its-kronos/Databoard/Production/PCB/Databoard_BOM_FINAL.csv

No. | Quantity | Comment | Designator | Footprint | Value | Manufacturer Part | Manufacturer | Supplier Part | Supplier
1 | 6 | 100nF | C1,C2,C3,C4,C9,C13 | C0402 | 100nF | CL05B104KB54PNC | SAMSUNG(三星) | C307331 | LCSC
2 | 1 | 4.7uF | C5 | C0402 | 4.7uF | CL05A475MP5NRNC | SAMSUNG(三星) | C23733 | LCSC
3 | 1 | 10nF | C6 | C0402 | 10nF | CL05B103KB5NNNC | SAMSUNG(三星) | C15195 | LCSC
4 | 1 | 1uF | C8 | C0402 | 1uF | CL05A105KA5NQNC | SAMSUNG(三星) | C52923 | LCSC
5 | 2 | 12pF | C11,C12 | C0402 | 12pF | 0402CG120J500NT | FH(风华) | C1547 | LCSC
6 | 1 | 22uF | C16 | C0603 | 22uF | CL10A226MQ8NRNC | SAMSUNG(三星) | C59461 | LCSC
7 | 1 | 10uF | C17 | C0402 | 10uF | CL05A106MQ5NUNC | SAMSUNG(三星) | C15525 | LCSC
8 | 2 | 10pF | C18,C19 | C0402 | 10pF | CL05C100JB5NNNC | SAMSUNG(三星) | C32949 | LCSC
9 | 1 | TF PUSH | CARD1 | TF-SMD_TF-PUSH |  | TF PUSH | SHOU HAN(首韩) | C393941 | LCSC
10 | 1 | SM4007PL | D1 | SOD-123F_L2.8-W1.8-LS3.7-RD |  | SM4007PL | MDD(辰达半导体) | C64898 | LCSC
11 | 3 | SMF5.0A | D2,D3,D4 | SOD-123FL_L2.7-W1.8-LS3.8-RD |  | SMF5.0A | 宏迦橙 | C19077497 | LCSC
12 | 1 | KH-2.54PH180-1X3P-L11.5 | H1 | HDR-TH_3P-P2.54-V-M |  | KH-2.54PH180-1X3P-L11.5 | kinghelm(金航标) | C2932698 | LCSC
13 | 2 | 2.54-1*20P直针 | J1,J2 | HDR-TH_20P-P2.54-V-M-1 |  | 2.54-1*20P直针 | BOOMELE(博穆精密) | C50981 | LCSC
14 | 4 | BSS84 | Q1,Q2,Q3,Q4 | SOT-23-3_L2.9-W1.3-P1.90-LS2.4-BR-1 |  | BSS84 | 宏嘉诚 | C7420340 | LCSC
15 | 6 | 10kΩ | R1,R5,R7,R8,R9,R10 | R0402 | 10kΩ | 0402WGF1002TCE | UNI-ROYAL(厚声) | C25744 | LCSC
16 | 2 | 5.1kΩ | R2,R3 | R0402 | 5.1kΩ | 0402WGF5101TCE | UNI-ROYAL(厚声) | C25905 | LCSC
17 | 1 | 1.5kΩ | R6 | R0402 | 1.5kΩ | 0402WGF1501TCE | UNI-ROYAL(厚声) | C25867 | LCSC
18 | 2 | TS-1088-AR02016 | SW1,SW2 | SW-SMD_L3.9-W3.0-P4.45 |  | TS-1088-AR02016 | XUNPU(讯普) | C720477 | LCSC
19 | 1 | STM32F103C8T6 | U1 | LQFP-48_L7.0-W7.0-P0.50-LS9.0-BL |  | STM32F103C8T6 | ST(意法半导体) | C8734 | LCSC
20 | 1 | AMS1117-3.3 | U2 | SOT-223-3_L6.5-W3.4-P2.30-LS7.0-BR |  | AMS1117-3.3 | AMS | C6186 | LCSC
21 | 1 | 2.4GHz | U3 | WIFI-SMD_ESP32-MINI-1-N4 | 2.4GHz | ESP32-S2-MINI-2-N4 | ESPRESSIF(乐鑫) | C3013906 | LCSC
22 | 1 | TYPE-C16PIN | USB1 | USB-C-SMD_TYPE-C16PIN |  | TYPE-C16PIN | SHOU HAN(首韩) | C393939 | LCSC
23 | 1 | 16MHz | X1 | OSC-SMD_4P-L3.2-W2.5-BL | 16MHz | X322516MLB4SI | YXC(扬兴晶振) | C13738 | LCSC
24 | 1 | 32.768kHz | X2 | OSC-SMD_L3.2-W1.5 | 32.768kHz | SC-32S32.768kHz20PPM7pF | Seiko(精工) | C97604 | LCSC
