its-kronos/Databoard/(list of files, drawings)

Other design files:
PCB/Databoard.epro
