its-kronos/Databoard/JOURNAL.md

Total design time: 22.75h

# 8/1/25

- Started by creating some ideas of what I generally wanted this project to be, and thanks to a few people, I came up with a basic idea.



- After coming up with the basic idea, I started to look at documentation for the STM32 chip I was going to be using, and started creating the schematic, which was pretty easy, but just a bit challenging since I've only been used to the Raspberry Pi documentation for their chips, which were very detailed and easy to follo whwne compared to STM







- Towards the end, I knew that a crystal that works with this chip would be hard to find. I looked at the only basic JLCPCB part (which would avoid a 3 dollar fee for assembly) that resonates at 16 MHZ, and it took about an hour of calculating to determine that it was probably fine. The only thing I wasn't able to calculate was how good the crystal would be over periods of time since I would need to measure how current flows through the crystal, which would be impossible without specific tools (oscilloscope) and the crystal itself.

- 

- Also, I decided that I would be "starting over" and creating the PCB in easyEDA instead of Kicad since the Twist You Ship We Ship of Hackclub has two possible routes of funding for the PCB. One of them is to use any EDA but track your time, which doesn't include looking at documentation for 5 dollars an hour, or using easyEDA and receiving a grant from JLCPCB instead, with any amount of time
- Using easyEDA would mean that I wouldn't have to worry about the PCB budget, especially since most of it isn't even tracked due to how documentation heavy hardware design can be

**time: 3 hours**

# 8/3/25

- Ported over everything to easyEDA (without importing, just remade everything)
- After, I added a 32.768 KHZ crystal for the RTC of the chip to be more accurate, especially since time tracking is something that can be fundamental for a board based on collecting data.
- Finally, I started implementing USBC and esd protection with the USBLC6, but then I learned about how I could use TVS diodes for protection, which would be cheaper, and something I implement during the next session.



- Also, towards the end, I learned about how the specific MCU I'm using requires 1.5k Ohm pull up resistor on USB DP, and after doing some research I decided that the next session I would include an P channel mosfet to control it



**time: 2.5 hours**

- Finished circuits for USB + ESD protection



- Did a lot of research on what type of converter I should use, since I would like for it to be compatable with different types of batteries, but this wasn't the easiest due to trying to make the board as cheap as possible. I was able to find a convertor that would allow for a stable conversion from 4.5 volts to 16 volts, which would be pretty good for things like 9V battery



**time: 1 hour**

# 8/4/25

- Started laying out everything and sourced other parts, such as the WIFI module and microSD reader, and then learned about how LDOs (the dropout voltage regulator I chose) would be inefficient, so now I'm trying to find a buck regulator instead





**time: 2 hours**

- Did some research about a buck regulator, but turns out they would require way too many extended components, so although it would be less efficient, it would drive up the costs



- Changed up the layout a bit to make it neater as well as finished it, and added headers for debugging (SWDIO), and then started some of the start of routing, especially for important traces like USB and some of the power traces



**time: 2 hours**

# 8/5/25

- Did a lot of the routing for the traces, and GPIO pins, especially the ones at the top of the STM32.



- However, after doing this I noticed that most of the ADC pins (convert Analog signals to binary) would be used for communication with the SD card and the wifi chip, which would be a waste, so I started to restart and better plan this layout, trying to make sure that I would keep in mind which signals are more important than others (like communication between components > GPIO)



**time: 2h 30m**

- I then spent quite a bit of time on routing, trying to make sure that it was neat, and when I got to the part where I had to route a second UART to communicate with the ESP32, I realized that Instead of using two GPIOs, I could use one and have a switch that switches between the REPL UART pins to the UART pins one would use for communicating with custom code. 



- During this time, I was able to successfully route 50% of the GPIO headers (and there were a few moment where I pretty much boxed myself in really badly)

  

  

- This is quite tightly spaced:



**time: 2h45m**

# 8/6/25

- This was a really big session especially due to today being the final day for the YSWS.

- To start, I completely finished routing the board, which was really easy due to it pretty much being only straight lines.
- After, I proceeded to check over everything in the schematic and the documentation, to make sure that everything would work

- Unfortunately, the crystal that I was using for the RTC wouldn't work due to having too much of a load capacitance. This means that I must go with an extended component (which adds 3 dollars to the cost) and also reroute a small amount of the board.



- I also had to end up swapping RX and PB6 here, and the reason for that was that I thought RX (receive) would be sending the signals (I wasn't really thinking about it)



- Now, the only thing left is the art, and I was able to completely finish the top side, which in my opinion, looks really good, but took me a lot of time due to me being pretty bad at art.

image (8)

**time: ~5h**

- I started to add images to the back of the board, and one thing that was a challenge was how imported images always were bottom-most compared to patterns made natively in easyeda which was a pain to fix and move the shapes/reshape them.



- Eventually I was able to get it looking pretty good after quite a bit of time



- Also turns out that multicolor silkscreen requires a white board, and at 0.8mm board thickness it requires a special surcharge of 32 dollars, so I changed it to 1.6 and redid the USB traces, as board thickness impacts impedence.



**time: ~2h**

# 8/18/25

- Got the PCB!!
- Took a couple images in RAW format, which I spent quite a bit of time on
-  Each image was about 100mb, so I'll just share compressed ~10MB versions

 

 

 

 



**time: 30m**

# 8/19/25

- started by trying to make custom circuit python build and set up WSL and did a lot of the steps there. Eventually, I found out that circuit python doesn't support the STM32F1 series due to there being too little inbuilt flash (probably, 64 kb)



- Also, STM32F1 doesn't have an inbuilt USB bootloader, so I have to use an open sourced one and flash via SWD (and I don't have a debugger!)

- To make matters worse, I'm going to have to modify the bootloader for USB enumeration because most of them expect an 8 mhz clock while mine uses a 16 mhz

**time: 1h45m**

# 8/19/25

- I'm tired, and nothing i've tried worked, so there won't be that much for me to add images about, which sucks

- So first, I tried using maple bootloader and after a while I successfully changed the value of a register!
- Turns out this was a waste of time and outdated firmware

- While doing this, i tried to create an SWD interface on a pi 3B+ with openocd (took so long to build), which failed to connect, and then I tried to create one on one of my RP2040 based devboards, which also failed to connect, being another timewaste

- I then moved on to stm32duino and spent a large chunk of time trying to figure out how to change the values of the RCC_CFGR registor to allow for the 16 MHZ clock, but now I just think that its a board plugin for the arduino IDE and not meant to be used as a bootloader (?)

- Anyways, I then tried to do a USB UART bridge on the other devboard, which failed for unknown reasons (works to flash the secondary MCU on the board).
- I spent a while trying to debug this, by using stuff like a nano v3 and an LED to "read" it, but no data came out

- Anyways, I'm just going to sleep on this project and home I can figure out something tomorrow

**time:4h30m**

# 8/20/25

- Turns out, I was using the wrong IO pins. I defined the UART IO pins as 8 and 9, but instead I was using pins 18 and 19, which was 100% my problem.
- After trying to use this, it still failed, but this was because the baudrate was too high, and I was successfully able to properly send and read the byte from the nano.



- Now I should be able to hook it up and flash a binary
- Also, I discovered that for using stm32duino, theres a bootloader derived from Maple that's more up to date, which makes it a lot easier to use

**time 1h45m**

# 8/20/25

- So even though i was able to send the correct byte, the stm32 just refused to respond with anything at all, there isn't much to show for this, since its really just a whole lot of nothing. I spent about 3-ish hours trying to get this to work, but this was futile

- Eventually, I decided to try SWD debug probe via openocd again, and for some reason, it just worked today, and I have no idea why
- Either way, I was able to successfully able to flash a binary onto the device, so the next step would be to customize the opensource maple derivative to account for the 16mhz crystal, which should allow me to use it with stm32duino and in turn, the arduino ide

image (10)

**time 4h (long, I know)**

# 8/21/25

- Recompiled code to work with 16M crystal, which was easy due to their being a config
- Turns out this bootloader only works with DFU, and doesn't work well with arduino, so I did a couple hours of searching online, and eventually found out that theres a new, better bootloader that works with the offical STM32 core for Arduino

- Also, this new bootloader that I will implement next session doesn't require drivers!



**time: 3h15m (mainly due to the failing of the first bootloader)**

# 8/21/25

- The HID bootloader failed, even after doing quite a bit of research

- Eventually found a CDC driver, but it doesn't work with arduino, and the creator of it hasn't updated it anytime recently, so no hope there

- Went back to maple DFU bootloader, and I couldn't get that to work, so I honestly feel that theres nowhere to really go without external help

- Will probably take a break to install Arch linux dual boot while waiting for my account to get approved for stmduino forums

**time: 2h**

# 8/29/25

- Putting the binary directly on to the board wouldn't work obviously due to the crystal mismatch, but after some research i found out that I could create a pull request to add a new board to the offical stm32duino core
- Took a lot longer than expected due to the instructions not being as detailed as I would like, but I was able to get it done



**time: 2.5h**

# 9/12/25

- Fixed up the PR to match the feedback, not much here except me just changing stuff to match what the maintainer for STM32DUINO said to do



**time: 1h**

# 9/26/25

- IT WORKS IT WORKS



**time: 30m**

# 9/26/25

- Now comes the challenging part of getting the ESP32 S2 on the board flashed with micropython
- Spent about 20-25 minutes looking over my schematic and datasheets
- made some code to put the esp in bootloader and forward usb signals to UART for ~30m, but I wasn't able to use esptool on it



- I could, however, confirm that the esp32s2 was going into bootloader mode

**time: 1h**

# 9/27/25

- Was able to debug everything except the connection between the STM and ESP



- Also managed to unjumble the bootloader ROM message

**time: 1h**

# 9/27/25

- Debugged everything, and was even able to read serial data from the ESP32, but ESPtool always said no serial data found
- Tried again and again to get ESPTOOL to even see serial data but nothing worked, and even a [reddit](https://www.reddit.com/r/esp32/comments/1ns5k6q/esptool_no_serial_data_received_esp32_is/) post came empty-handed



**time: 1h**

# 9/28/25 - FINAL DEVLOG

- Yeah soooo i gave up trying to get the ESP part of the devboard working. I honestly have no idea where to debug next, so I decided that it's a lost cause

- HOWEVER... there is still the SD card portion, which worked perfectly!



- Learning how to use the SD card and create an SPI interface was pretty interesting, but the compile time for the code was pretty painful (especially when I had to do it over and over again to test.
- Anyways, a demo video will be coming soon!

**time: 1.5h**
