its-kronos/Databoard/Production/Firmware/Uncompiled/Databoard.ino

#include <SPI.h>
#include <SdFat.h>

SPIClass sdSPI(MICROSD_MOSI, MICROSD_MISO, MICROSD_CLK);
SdFs SD;
FsFile file;

bool SDBegun = true;
void setup() {
  // put your setup code here, to run once:

  Serial.begin(9600);

  sdSPI.begin();

  SdSpiConfig spiConfig(MICROSD_EN, DEDICATED_SPI, SD_SCK_MHZ(4), &sdSPI);

  SDBegun = SD.begin(spiConfig);
  if (!SDBegun){
    digitalWrite(IO3, HIGH);
  }

  pinMode(IO1, OUTPUT);
  pinMode(IO2, INPUT_PULLDOWN);


}

bool wrote = false;

void loop() {
  if (digitalRead(IO2) && !wrote){
    wrote = true;    
    
    if (SDBegun){
      file = SD.open("hackclub.txt", FILE_WRITE);

      if (file){
        file.println(R"rawliteral(Hello fellow Hackclubbers. I am here to inform you that you MUST join #chronosphere NOW (and maybe #arca, #tobi, and #shink).
        
SHAW

          ⠀⠀⠀⠀⠀⠀⠀⠀⠀⠀⠀⠀⠀⠀⠀⠀⠀⠀⠀  ⣀⣠⣤⡄⠀⠀⠀⠀⠀⠀⠀
⠀⠀⠀⠀⠀⠀⠀⠀⠀⠀⠀⠀⠀⠀⠀⠀⠀⠀⠀⠀⠀⠀⠀⠀⣠⣴⣾⠿⣻⣿⠟⠁⠀⠀⠀⠀⣠⣾⡆
⠀⠀⠀⠀⠀⠀⠀⠀⠀⠀⠀⠀⠀⠀⠀⠀⠀⠀⠀⠀⠀⣀⣴⡿⠟⢉⣴⣾⠟⠁⠀⠀⠀⢀⣴⡿⠋⣿⠇
⠀⠀⠀⠀⠀⠀⠀⠀⠀⠀⠀⠀⠀⠀⠀⠀⠀⠀⢀⣤⣾⠟⠉⢀⣼⣿⠟⠁⠀⠀⠀⢀⣴⡿⠋⠀⣸⡟⠀
⠀⠀⠀⠀⠀⠀⠀⠀⠀⠀⠀⠀⠀⠀⠀⠀⣠⣴⡿⠟⠁⠀⣠⣾⠟⠁⠀⠀⠀⢀⣴⡿⠋⠀⠀⢠⣿⠁⠀
⠀⠀⠀⠀⠀⠀⠀⠀⠀⠀⠀⠀⠀⠀⢀⣴⡿⠋⠀⠀⢀⣾⡿⠁⠀⠀⠀⢀⣴⡿⠋⠀⠀⠀⢀⣾⠏⠀⠀
⠀⠀⠀⠀⠀⠀⠀⠀⠀⠀⠀⠀⠀⣰⣿⠟⠀⠀⠀⣰⣿⠏⠀⠀⠀⢀⣴⡿⠋⠀⠀⠀⠀⠀⣼⡟⠀⠀⠀
⠀⠀⠀⠀⠀⠀⠀⠀⠀⠀⠀⢀⣾⡿⠃⠀⠀⠀⣼⡿⠃⠀⠀⢀⣴⣿⠟⠁⠀⠀⠀⠀⠀⣼⡟⠀⠀⠀⠀
⠀⠀⠀⠀⠀⠀⠀⠀⠀⠀⢀⣾⠟⠀⠀⠀⠀⣸⡿⠁⠀⠀⣴⣿⠟⠁⠀⠀⠀⠀⠀⠀⣼⡿⠀⠀⠀⠀⠀
⠀⠀⠀⠀⠀⠀⠀⠀⠀⢀⣾⠏⠀⠀⠀⠀⢠⣿⠁⢀⣴⣾⠟⠁⠀⠀⠀⠀⠀⠀⠀⣴⡿⠀⠀⠀⠀⠀⠀
⠀⠀⠀⠀⠀⠀⠀⠀⠀⣾⠏⠀⠀⠀⠀⠀⠸⣿⣶⠿⠛⠁⠀⠀⠀⠀⠀⠀⠀⠀⣼⡿⠁⠀⠀⠀⠀⠀⠀
⠀⠀⠀⠀⠀⠀⠀⠀⣸⡿⠀⠀⠀⠀⠀⠀⠀⠀⠀⠀⠀⠀⠀⠀⠀⠀⠀⠀⢀⣼⡿⠁⠀⠀⠀⠀⠀⠀⠀
⠀⠀⠀⠀⠀⠀⠀⢠⣿⠁⠀⠀⠀⠀⠀⠀⠀⠀⠀⠀⠀⠀⠀⠀⠀⠀⠀⣠⣾⠟⠀⠀⠀⠀⠀⠀⠀⠀⠀
⠀⠀⠀⠀⠀⠀⠀⣸⡏⠀⠀⠀⠀⠀⠀⠀⠀⠀⠀⠀⠀⠀⠀⠀⠀⢀⣴⡿⠃⠀⠀⠀⠀⠀⠀⠀⠀⠀⠀
⠀⠀⠀⠀⠀⠀⠀⣿⡇⠀⠀⠀⠀⠀⠀⠀⠀⠀⠀⠀⠀⠀⠀⠀⣠⣿⠏⠀⠀⠀⠀⠀⠀⠀⠀⠀⠀⠀⠀
⠀⠀⠀⠀⠀⠀⠀⣿⡇⣿⣧⡀⠀⠀⠀⣠⣴⣶⣶⠀⠀⠀⣠⣾⠟⠁⠀⠀⠀⠀⠀⠀⠀⠀⠀⠀⠀⠀⠀
⠀⠀⠀⠀⠀⠀⠀⢹⣇⢻⣿⡇⠀⢀⣾⣿⣿⣿⡟⠀⣠⣾⠟⠁⠀⠀⠀⠀⠀⠀⠀⠀⠀⠀⠀⠀⠀⠀⠀
⠀⠀⠀⠀⠀⠀⠀⠈⢿⣮⡛⠃⠀⠈⠻⠿⠿⣫⣴⡿⠟⠁⠀⠀⠀⠀⠀⠀⠀⠀⠀⠀⠀⠀⠀⠀⠀⠀⠀
⠀⠀⠀⠀⠀⠀⠀⠀⢠⣿⣿⣿⣿⣿⡿⣿⣿⣿⣿⣄⠀⠀⠀⠀⠀⠀⠀⠀⠀⠀⠀⠀⠀⠀⠀⠀⠀⠀⠀
⠀⠀⠀⠀⠀⠀⠀⠀⠈⠙⣿⣦⡘⠀⠀⠀⢠⣾⡿⠋⠀⠀⠀⠀⠀⠀⠀⠀⠀⠀⠀⠀⠀⠀⠀⠀⠀⠀⠀
⠀⠀⠀⠀⠀⠀⠀⠀⠀⠀⢨⣿⣇⡀⣠⢠⣼⣿⡀⠀⠀⠀⠀⠀⠀⠀⠀⠀⠀⠀⠀⠀⠀⠀⠀⠀⠀⠀⠀
⠀⠀⠀⠀⠀⠀⠀⠀⠀⣰⣿⡿⣸⡇⢿⣇⢿⣿⣿⣦⡀⠀⠀⠀⠀⠀⠀⠀⠀⠀⠀⠀⠀⠀⠀⠀⠀⠀⠀
⠀⠀⠀⠀⠀⠀⠀⣠⣾⣿⣿⠃⣿⡇⠸⣿⡌⢻⣿⣿⣿⣶⣄⡀⠀⠀⠀⠀⠀⠀⠀⠀⠀⠀⠀⠀⠀⠀⠀
⠀⠀⠀⠀⠀⣠⣾⡿⣿⣿⠃⠀⣿⡇⠀⢹⣿⡄⠘⠻⣿⣯⡻⢿⣶⣄⠀⠀⠀⠀⠀⠀⠀⠀⠀⠀⠀⠀⠀
⠀⠀⠀⣠⣾⠿⢋⣼⡿⠃⠀⠀⣿⠃⠀⠀⠻⣿⣆⠀⠈⠻⣿⣷⣝⠻⣿⣦⠀⠀⠀⠀⠀⠀⠀⠀⠀⠀⠀
⠀⢀⣼⡿⠋⣠⣿⡿⠁⠀⠀⢸⣿⠀⠀⠀⠀⠹⣿⣧⡀⠀⠈⠙⢿⣷⡮⡻⣿⢂⠀⠀⠀⠀⠀⠀⠀⠀⠀
⢀⣾⡿⠁⣰⣿⠟⠀⠀⠀⠀⣿⡟⠀⠀⠀⠀⠀⠈⢿⣿⣄⠀⠀⠀⠙⢿⣿⣌⣿⡇⠀⠀⠀⠀⠀⠀⠀⠀
⠘⣿⣧⣴⣿⡟⠀⠀⠀⠀⣸⣿⠃⠀⠀⠀⠀⠀⠀⠀⠻⣿⣦⠀⠀⣠⣶⣿⣿⡿⠃⠀⠀⠀⠀⠀⠀⠀⠀
⠀⠀⠉⠻⣿⣤⣄⣀⠀⠀⣿⡿⠀⠀⠀⠀⠀⢀⣀⣤⣤⣿⣿⣷⣾⠿⢿⡿⠛⠁⠀⠀⠀⠀⠀⠀⠀⠀⠀
⠀⠀⠀⠀⠀⠙⠿⠿⠿⠿⣿⣷⣶⣶⣶⣶⣶⣿⣿⣿⣿⣿⣿⠟⠁⠀⠀⠀⠀⠀⠀⠀⠀⠀⠀⠀⠀⠀⠀
⠀⠀⠀⠀⠀⠀⠀⠀⠀⠀⠀⠀⠀⢿⣿⣇⠀⠀⢹⣿⣿⠀⠀⠀⠀⠀⠀⠀⠀⠀⠀⠀⠀⠀⠀⠀⠀⠀⠀
⠀⠀⠀⠀⠀⠀⠀⠀⠀⠀⠀⠀⠀⠘⣿⣿⡀⠀⠸⣿⣿⠀⠀⠀⠀⠀⠀⠀⠀⠀⠀⠀⠀⠀⠀⠀⠀⠀⠀
⠀⠀⠀⠀⠀⠀⠀⠀⠀⠀⠀⠀⠀⠀⢻⣿⡇⠀⠀⣿⣿⠀⠀⠀⠀⠀⠀⠀⠀⠀⠀⠀⠀⠀⠀⠀⠀⠀⠀
⠀⠀⠀⠀⠀⠀⠀⠀⠀⠀⠀⠀⠀⠀⠈⣿⣿⠀⠀⢻⣿⠀⠀⠀⠀⠀⠀⠀⠀⠀⠀⠀⠀⠀⠀⠀⠀⠀⠀
⠀⠀⠀⠀⠀⠀⠀⠀⠀⠀⠀⠀⠀⠀⠀⢸⣿⠀⠀⢸⣿⠀⠀⠀⠀⠀⠀⠀⠀⠀⠀⠀⠀⠀⠀⠀⠀⠀⠀
⠀⠀⠀⠀⠀⠀⠀⠀⠀⠀⠀⠀⠀⠀⠀⠘⣿⡆⠀⢸⣿⠀⠀⠀⠀⠀⠀⠀⠀⠀⠀⠀⠀⠀⠀⠀⠀⠀⠀
⠀⠀⠀⠀⠀⠀⠀⠀⠀⠀⠀⠀⠀⠀⠀⠀⢻⡇⠀⢸⣿⠀⠀⠀⠀⠀⠀⠀⠀⠀⠀⠀⠀⠀⠀⠀⠀⠀⠀
⠀⠀⠀⠀⠀⠀⠀⠀⠀⠀⠀⠀⠀⠀⠀⠀⠘⠃⠀⠘⠟⠀⠀⠀⠀⠀⠀⠀⠀⠀⠀⠀⠀⠀⠀⠀⠀⠀⠀

Hornet tells you that you should vote for my project... or else
        )rawliteral");
        file.close();
      }
      else{
        digitalWrite(IO3, HIGH);
      }
    }
    
  }

  if (wrote){
    digitalWrite(IO1, HIGH);
    delay(200);
    digitalWrite(IO1, LOW);
    delay(200);
  }
  else{
    delay(100);
  }
}
 
