its-kronos/Databoard/(commit log)

2025-08-08 add production PCB files
    [Databoard_BOM_FINAL.csv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]
2025-08-08 Update README.md - add schematic
2025-08-09 Add EASYEDA PCB file
    [Databoard.epro]
2025-09-27 Update JOURNAL.md - 9/26/25 the base code from stm32duino works
2025-09-29 add arduino binary
2025-09-29 add arduino project
